portiqohq/portiqo-key/portiqo-key-hw/pcb/portiqo-key.kicad_pcb

## KiCad design portiqo-key-hw/pcb/portiqo-key.kicad_pcb (2025-07-25)

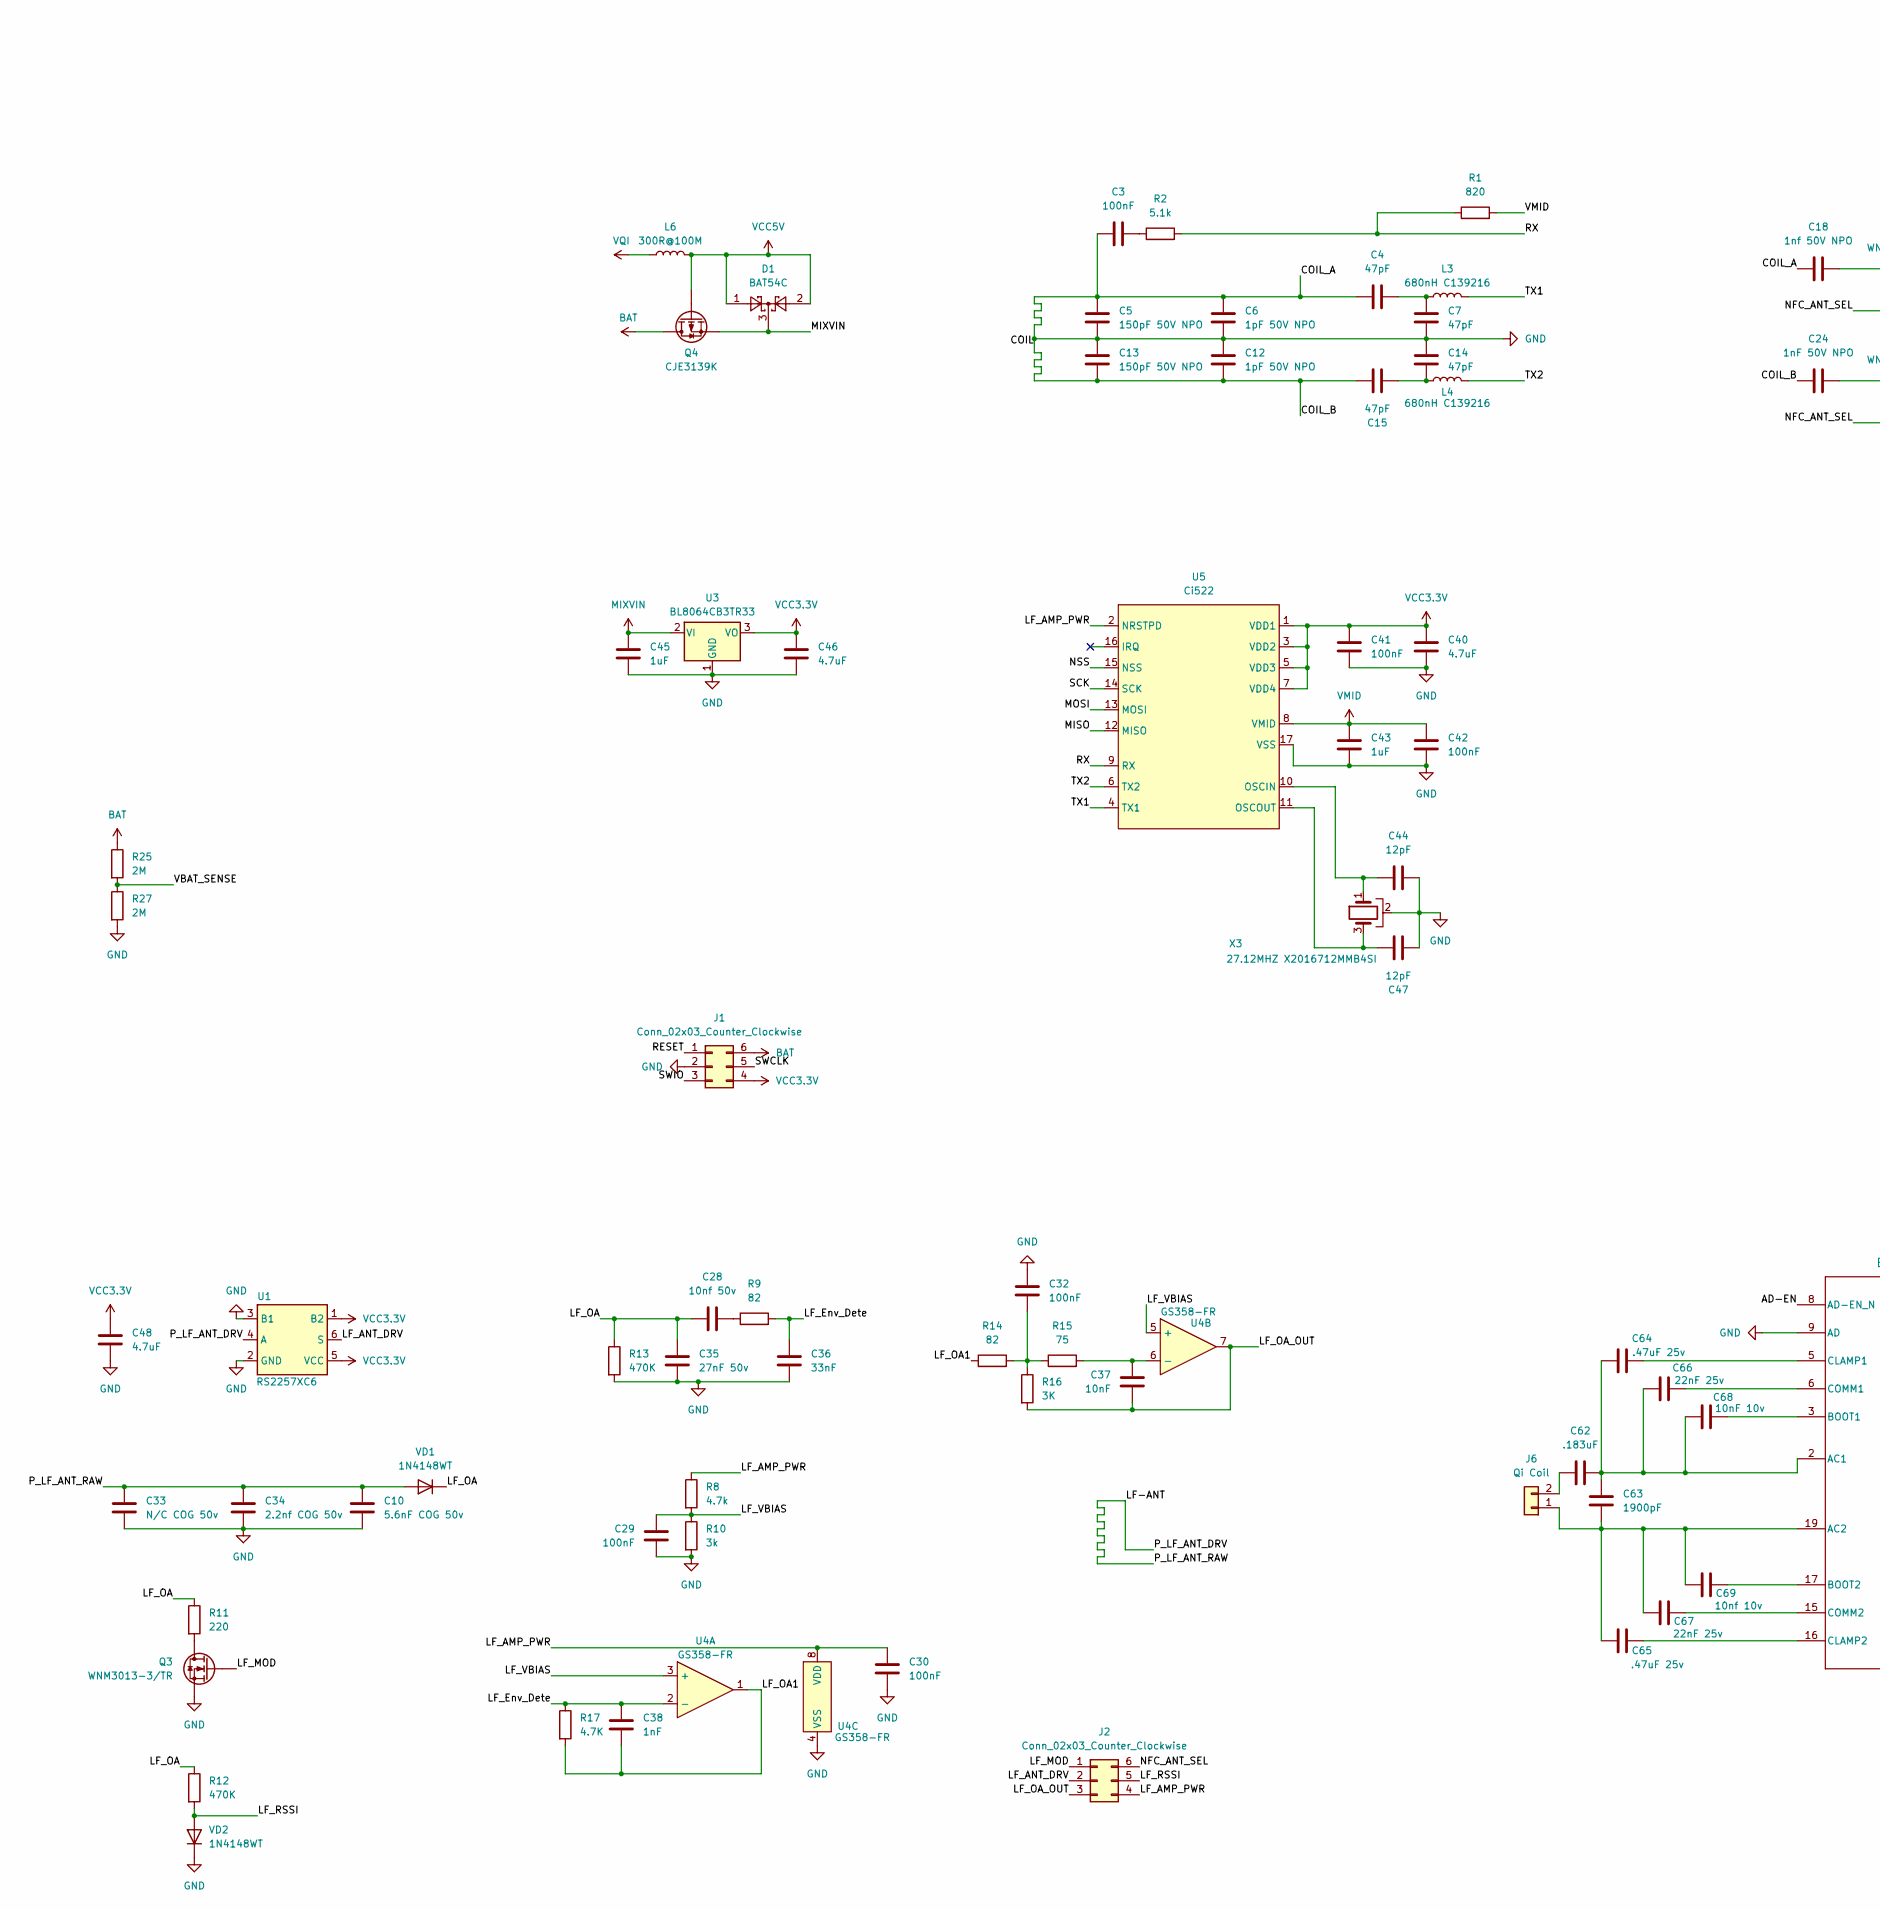
[picture p1: schematic portiqo-key.kicad_sch, part in row 1, column 1]

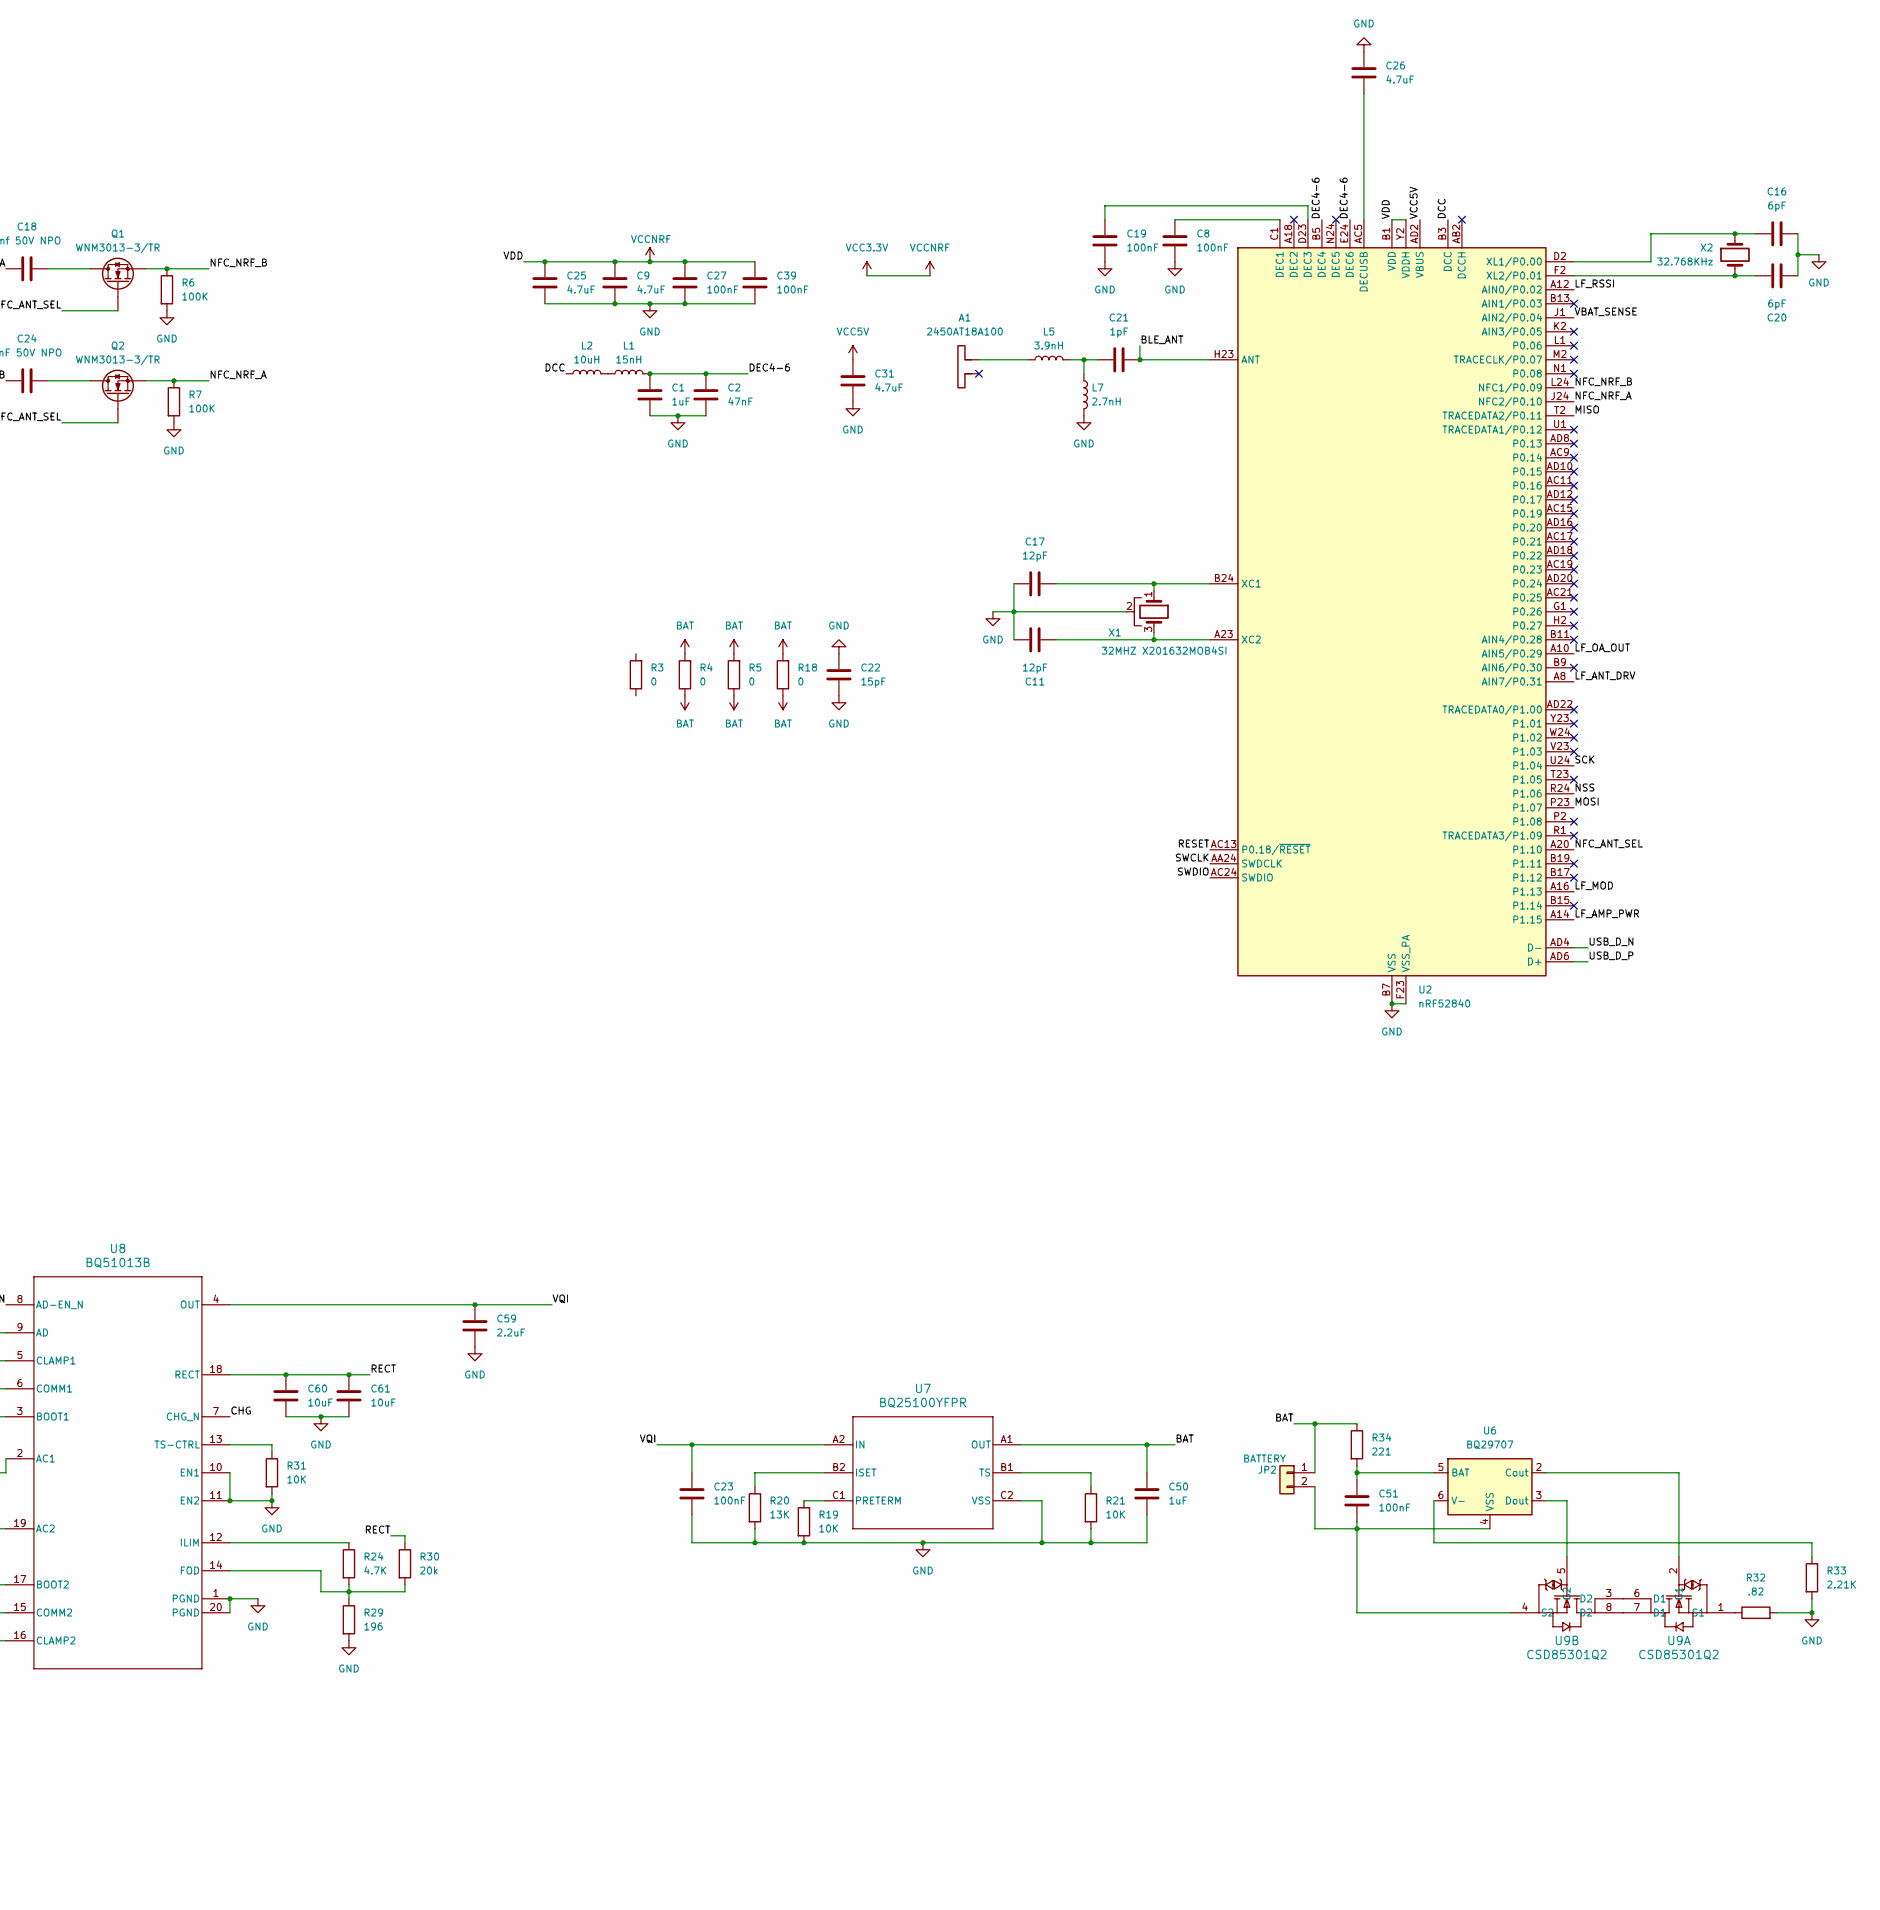
[picture p2: schematic portiqo-key.kicad_sch, part in row 1, column 2]

Parts:
A1: 2450AT18A100; Johanson_2450AT18x100
C1, C43, C45, C50: 1uF; C_0402_1005Metric
C2: 47nF; C_0402_1005Metric
C3, C8, C19, C23, C27, C29, C30, C32, C39, C41, C42, C51: 100nF; C_0402_1005Metric
C4, C7, C14, C15: 47pF; C_0402_1005Metric
C5, C13: 150pF 50V NPO; C_0402_1005Metric
C6, C12: 1pF 50V NPO; C_0402_1005Metric
C9, C25, C26, C31, C40, C46, C48: 4.7uF; C_0402_1005Metric
C10: 5.6nF COG 50v; C_0402_1005Metric
C11, C17, C44, C47: 12pF; C_0402_1005Metric
C16, C20: 6pF; C_0402_1005Metric
C18: 1nf 50V NPO; C_0402_1005Metric
C21: 1pF; C_0402_1005Metric
C22: 15pF; C_0402_1005Metric
C24: 1nF 50V NPO; C_0402_1005Metric
C28: 10nf 50v; C_0402_1005Metric
C33: N/C COG 50v; C_0402_1005Metric
C34: 2.2nf COG 50v; C_0402_1005Metric
C35: 27nF 50v; C_0402_1005Metric
C36: 33nF; C_0402_1005Metric
C37: 10nF; C_0402_1005Metric
C38: 1nF; C_0402_1005Metric
C59: 2.2uF; C_0402_1005Metric
C60, C61: 10uF; C_0402_1005Metric
C62: .183uF; C_0402_1005Metric
C63: 1900pF; C_0402_1005Metric
C64, C65: .47uF 25v; C_0402_1005Metric
C66, C67: 22nF 25v; C_0402_1005Metric
C68: 10nF 10v; C_0402_1005Metric
C69: 10nf 10v; C_0402_1005Metric
D1: BAT54C; SOT-23
J1, J2: Conn_02x03_Counter_Clockwise; Tag-Connect_TC2030-IDC-NL_2x03_P1.27mm_Vertical
J6: Qi Coil; Solderpad - 2 pin
JP2: BATTERY; Solderpad - 2 pin
L1: 15nH; L_0402_1005Metric
L2: 10uH; L_0603_1608Metric
L3, L4: 680nH C139216; L_0603_1608Metric
L5: 3.9nH; L_0402_1005Metric
L6: 300R@100M; L_0402_1005Metric
L7: 2.7nH; L_0402_1005Metric
Q1, Q2, Q3: WNM3013-3/TR; SOT-723
Q4: CJE3139K; SOT-523
R1: 820; R_0402_1005Metric
R2: 5.1k; R_0402_1005Metric
R3, R4, R5, R18: 0; R_0402_1005Metric
R6, R7: 100K; R_0402_1005Metric
R8: 4.7k; R_0402_1005Metric
R9, R14: 82; R_0402_1005Metric
R10: 3k; R_0402_1005Metric
R11: 220; R_0402_1005Metric
R12, R13: 470K; R_0402_1005Metric
R15: 75; R_0402_1005Metric
R16: 3K; R_0402_1005Metric
R17, R24: 4.7K; R_0402_1005Metric
R19, R21, R31: 10K; R_0402_1005Metric
R20: 13K; R_0402_1005Metric
R25, R27: 2M; R_0402_1005Metric
R29: 196; R_0402_1005Metric
R30: 20k; R_0402_1005Metric
R32: .82; R_0402_1005Metric
R33: 2.21K; R_0402_1005Metric
R34: 221; R_0402_1005Metric
U1: RS2257XC6; SOT-363_SC-70-6
U2: nRF52840; Nordic_AQFN-73-1EP_7x7mm_P0.5mm
U3: BL8064CB3TR33; SOT-23
U4: GS358-FR; DFN-8-1EP_2x2mm_P0.5mm_EP0.9x1.3mm
U5: Ci522; QFN-16-1EP_3x3mm_P0.5mm_EP1.9x1.9mm
U6: BQ29707; WSON-6_1.5x1.5mm_P0.5mm
U7: BQ25100YFPR; YFP0006AFAV
U8: BQ51013B; RHL20_2P05X3P05
U9: CSD85301Q2; DQK0006B
VD1, VD2: 1N4148WT; D_SOD-523
X1: 32MHZ X201632MOB4SI; Crystal_SMD_2016-4Pin_2.0x1.6mm
X2: 32.768KHz; SMD1610-2P X161032768KGD2SI CRYSTAL
X3: 27.12MHZ X2016712MMB4SI; Crystal_SMD_2016-4Pin_2.0x1.6mm

Connections:
/AD-EN: U8.8 (AD-EN_N)
/BLE_ANT: C21.2, U2.H23 (ANT)
/CHG: U8.7 (CHG_N)
/DCC: L2.1, U2.B3 (DCC)
/DEC4-6: C1.1, C2.1, L1.2, U2.B5 (DEC4), U2.E24 (DEC6)
/LF-ANT: C10.1, C33.1, C34.1, U1.4 (A), VD1.2 (A)
/LF_AMP_PWR: C30.1, J2.4, R8.1, U2.A14 (P1.15), U4.8 (VDD), U5.2 (NRSTPD)
/LF_ANT_DRV: J2.2, U1.6 (S), U2.A8 (AIN7/P0.31)
/LF_Env_Dete: C36.1, C38.1, R9.2, R17.1, U4.2 (-)
/LF_MOD: J2.1, Q3.G, U2.A16 (P1.13)
/LF_OA: C28.2, C35.1, R11.1, R12.1, R13.1, VD1.1 (K)
/LF_OA1: C38.2, R14.1, R17.2, U4.1
/LF_OA_OUT: C37.2, J2.3, R16.2, U2.A10 (AIN5/P0.29), U4.7
/LF_RSSI: J2.5, R12.2, U2.A12 (AIN0/P0.02), VD2.2 (A)
/LF_VBIAS: C29.1, R8.2, R10.1, U4.3 (+), U4.5 (+)
/MISO: U2.T2 (TRACEDATA2/P0.11), U5.12 (MISO)
/MOSI: U2.P23 (P1.07), U5.13 (MOSI)
/NFC_ANT_SEL: J2.6, Q1.G, Q2.G, U2.A20 (P1.10)
/NFC_NRF_A: Q2.S, R7.1, U2.J24 (NFC2/P0.10)
/NFC_NRF_B: Q1.S, R6.1, U2.L24 (NFC1/P0.09)
/NSS: U2.R24 (P1.06), U5.15 (NSS)
/RECT: C60.1, C61.1, R30.1, U8.18 (RECT)
/RESET: J1.1, U2.AC13 (P0.18/~RESET)
/RX: R1.1, R2.2, U5.9 (RX)
/SCK: U2.U24 (P1.04), U5.14 (SCK)
/SWCLK: J1.5, U2.AA24 (SWDCLK)
/TX1: L3.2, U5.4 (TX1)
/TX2: L4.1, U5.6 (TX2)
/USB_D_N: U2.AD4 (D-)
/USB_D_P: U2.AD6 (D+)
/VBAT_SENSE: R25.2, R27.1, U2.J1 (AIN2/P0.04)
BAT: C50.1, J1.6, JP2.1, Q4.D, R4.1, R4.2, R5.1, R5.2, R18.1, R18.2, R25.1, R34.1, U7.A1 (OUT)
GND: C1.2, C2.2, C3.1, C4.1, C5.1, C5.2, C6.1, C6.2, C7.2, C8.2, C9.2, C10.2, C11.1, C12.1, C12.2, C13.1, C13.2, C14.1, C15.2, C16.2, C17.1, C18.2, C19.2, C20.2, C22.1, C22.2, C23.2, C24.2, C25.2, C26.1, C27.2, C29.2, C30.2, C31.2, C32.1, C33.2, C34.2, C35.2, C36.2, C39.2, C40.2, C41.2, C42.2, C43.2, C44.2, C45.2, C46.2, C47.2, C48.2, C50.2, C59.2, C60.2, C61.2, J1.2, L7.2, Q3.S, R6.2, R7.2, R10.2, R13.2, R19.2, R20.2, R21.2, R27.2, R29.2, R31.2, R32.2, R33.2, U1.2 (GND), U1.3 (B1), U2.B7 (VSS), U2.EP (VSS), U2.F23 (VSS_PA), U3.1 (GND), U4.4 (VSS), U5.17 (VSS), U7.C2 (VSS), U8.1 (PGND), U8.9 (AD), U8.10 (EN1), U8.11 (EN2), U8.20 (PGND), U8.21, VD2.1 (K), X1.2, X3.2
MIXVIN: C45.1, D1.3, Q4.S, U3.2 (VI)
unnamed: A1.2, L5.1
unnamed: C3.2, R2.1
unnamed: C4.2, C7.1, L3.1
unnamed: C14.2, C15.1, L4.2
unnamed: C18.1, Q1.D
unnamed: C21.1, L5.2, L7.1
unnamed: C24.1, Q2.D
unnamed: C28.1, R9.1
unnamed: C32.2, R14.2, R15.1, R16.1
unnamed: C63.2, C65.1, C67.1, C69.1, J6.1, U8.19 (AC2)
unnamed: C62.1, J6.2
unnamed: C51.2, JP2.2, U6.4 (VSS), U9.4 (S2)
unnamed: L1.1, L2.2
unnamed: Q3.D, R11.2
unnamed: C8.1, U2.C1 (DEC1)
unnamed: C19.1, U2.D23 (DEC3)
unnamed: C26.2, U2.AC5 (DECUSB)
unnamed: C17.2, U2.B24 (XC1), X1.1
unnamed: C11.2, U2.A23 (XC2), X1.3
unnamed: C16.1, U2.D2 (XL1/P0.00), X2.1
unnamed: C20.1, U2.F2 (XL2/P0.01), X2.2
unnamed: C37.1, R15.2, U4.6 (-)
unnamed: C44.1, U5.10 (OSCIN), X3.1
unnamed: C47.1, U5.11 (OSCOUT), X3.3
unnamed: C51.1, R34.2, U6.5 (BAT)
unnamed: U6.2 (Cout), U9.2 (G1)
unnamed: U6.3 (Dout), U9.5 (G2)
unnamed: R33.1, U6.6 (V-)
unnamed: R20.1, U7.B2 (ISET)
unnamed: R19.1, U7.C1 (PRETERM)
unnamed: R21.1, U7.B1 (TS)
unnamed: C62.2, C63.1, C64.1, C66.1, C68.1, U8.2 (AC1)
unnamed: C68.2, U8.3 (BOOT1)
unnamed: C69.2, U8.17 (BOOT2)
unnamed: C64.2, U8.5 (CLAMP1)
unnamed: C65.2, U8.16 (CLAMP2)
unnamed: C66.2, U8.6 (COMM1)
unnamed: C67.2, U8.15 (COMM2)
unnamed: R24.2, R29.1, R30.2, U8.14 (FOD)
unnamed: R24.1, U8.12 (ILIM)
unnamed: R31.1, U8.13 (TS-CTRL)
unnamed: U9.3 (D2), U9.6 (D1)
unnamed: U9.7 (D1), U9.8 (D2)
unnamed: R32.1, U9.1 (S1)
VCC3.3V: C9.1, C25.1, C27.1, C39.1, C40.1, C41.1, C46.1, C48.1, J1.4, U1.1 (B2), U1.5 (VCC), U2.A22 (VDD), U2.AD14 (VDD), U2.AD23 (VDD), U2.B1 (VDD), U2.W1 (VDD), U2.Y2 (VDDH), U3.3 (VO), U5.1 (VDD1), U5.3 (VDD2), U5.5 (VDD3), U5.7 (VDD4)
VCC5V: C31.1, D1.1, D1.2, L6.2, Q4.G, U2.AD2 (VBUS)
VMID: C42.1, C43.1, R1.2, U5.8 (VMID)
VQI: C23.1, C59.1, L6.1, U7.A2 (IN), U8.4 (OUT)

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
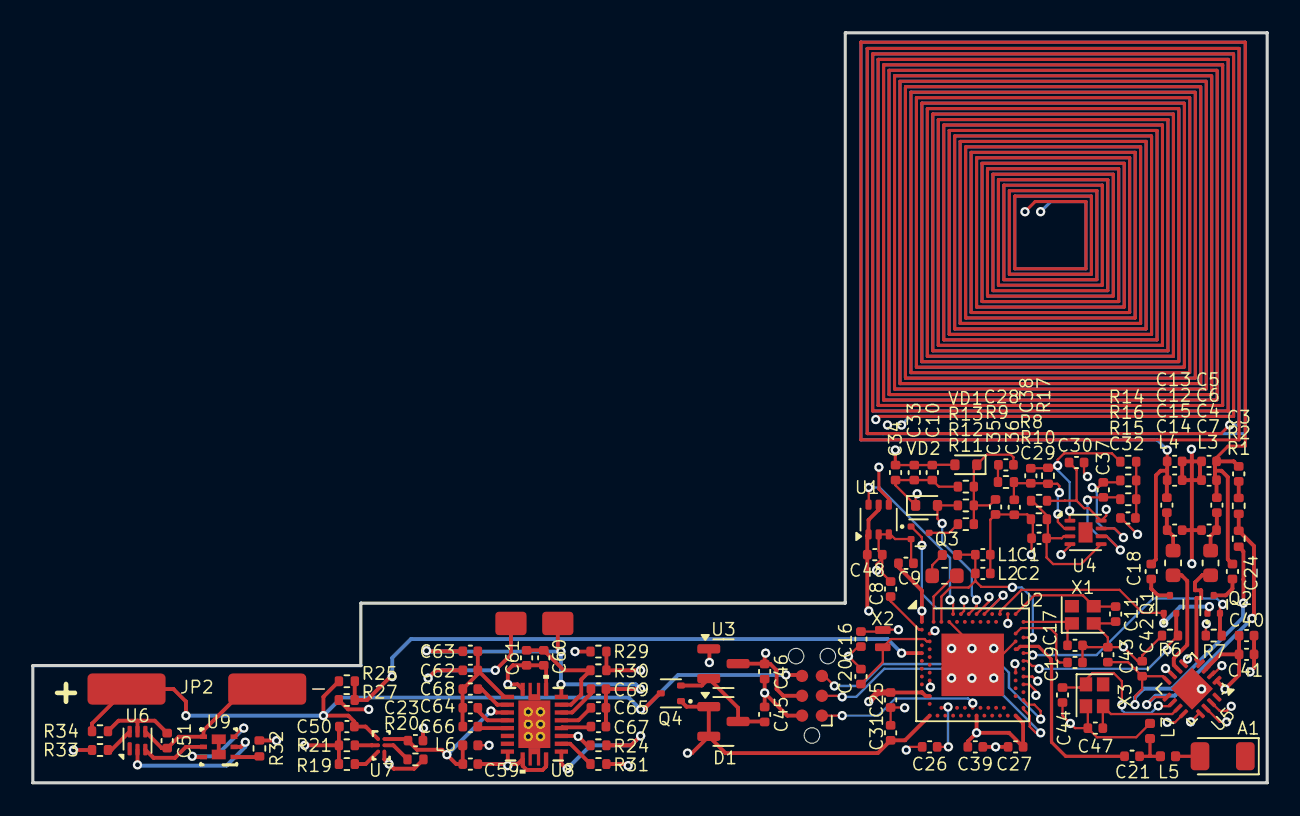
[picture p3: board portiqo-key.kicad_pcb from above]

Board: 4 copper layers, 79.0 x 48.0 mm, 116 parts (0 on the bottom side), 79 nets.
