portiqohq/portiqo-key/(commit log)

2025-07-18 Updated schematic for wireless charging. Added footprints for most ICs
    [chameleon-ultra.kicad_pcb, chameleon-ultra.kicad_sch, portiqo-key.kicad_pcb, portiqo-key.kicad_sch]
2025-07-25 HW V0.1
    [portiqo-key.kicad_pcb, portiqo-key.kicad_sch]
